Amosshinaayomi/C1-version-1/assets/C1_sketch_design.jpg

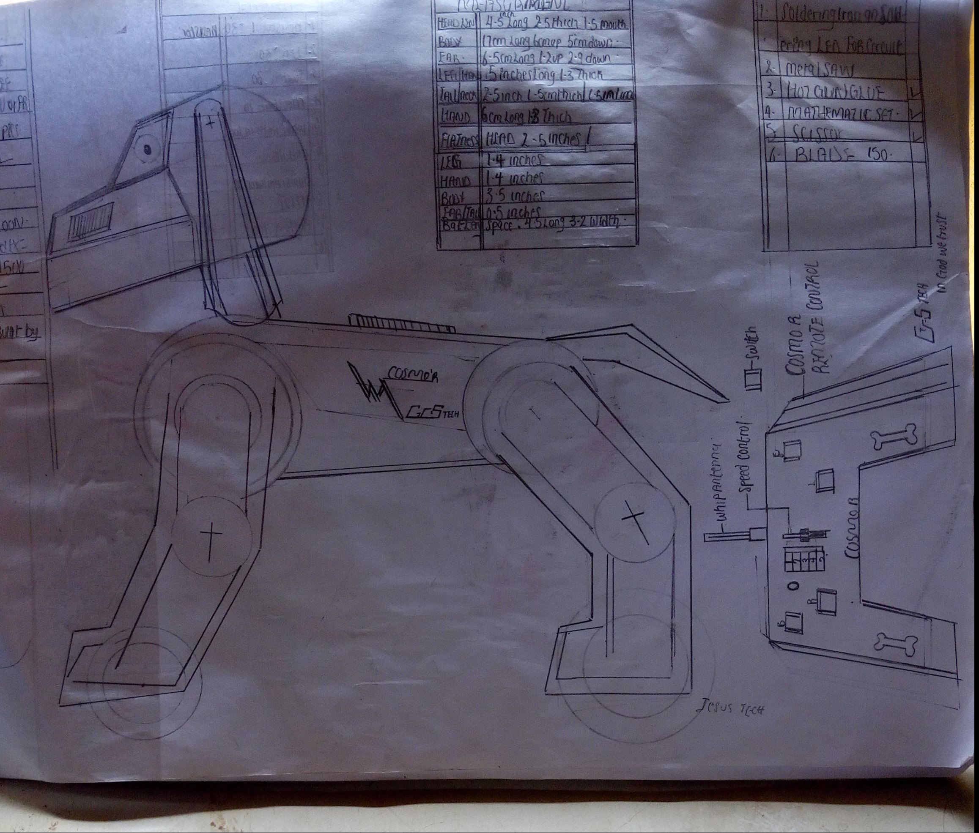
assets/C1_sketch_design.jpg
