Amosshinaayomi/C1-version-1/(list of files, drawings)

Other design files:
control_circuit_simulation/motor_servo_control .sim1
